HaraldForare/axis-projekt/media/IMG_20230502_111449.jpg

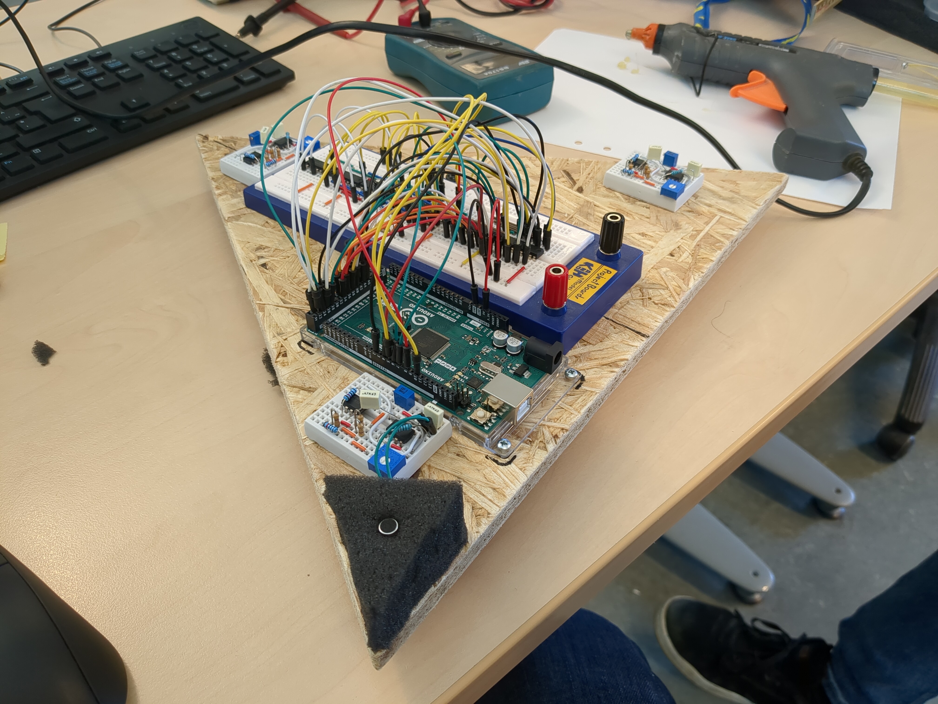
media/IMG_20230502_111449.jpg
