HaraldForare/axis-projekt/media/IMG_20230322_181715.jpg

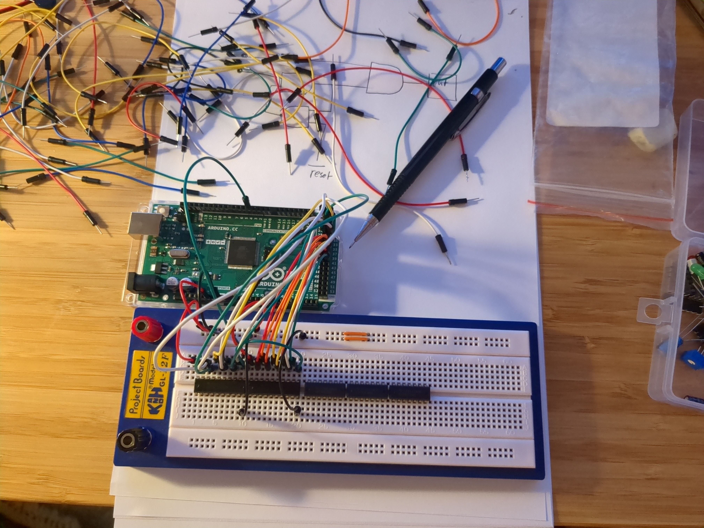
media/IMG_20230322_181715.jpg
