HaraldForare/axis-projekt/datasheets/AND_pinout.png

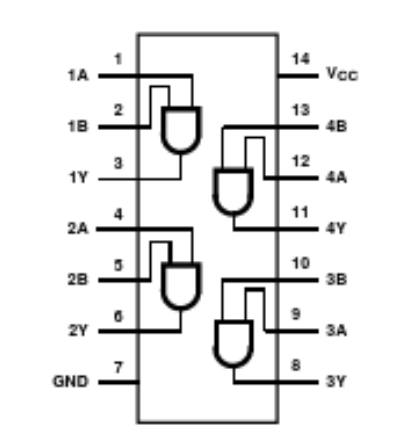
datasheets/AND_pinout.png
