HaraldForare/axis-projekt/datasheets/NAND_CD74HC00E.jpg

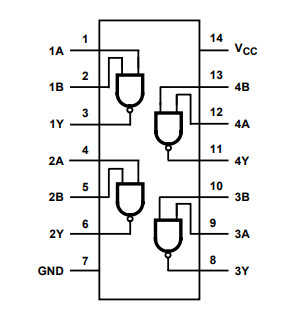
datasheets/NAND_CD74HC00E.jpg
