HaraldForare/axis-projekt/media/330957597_1179710302745747_4111378459915250923_n.png

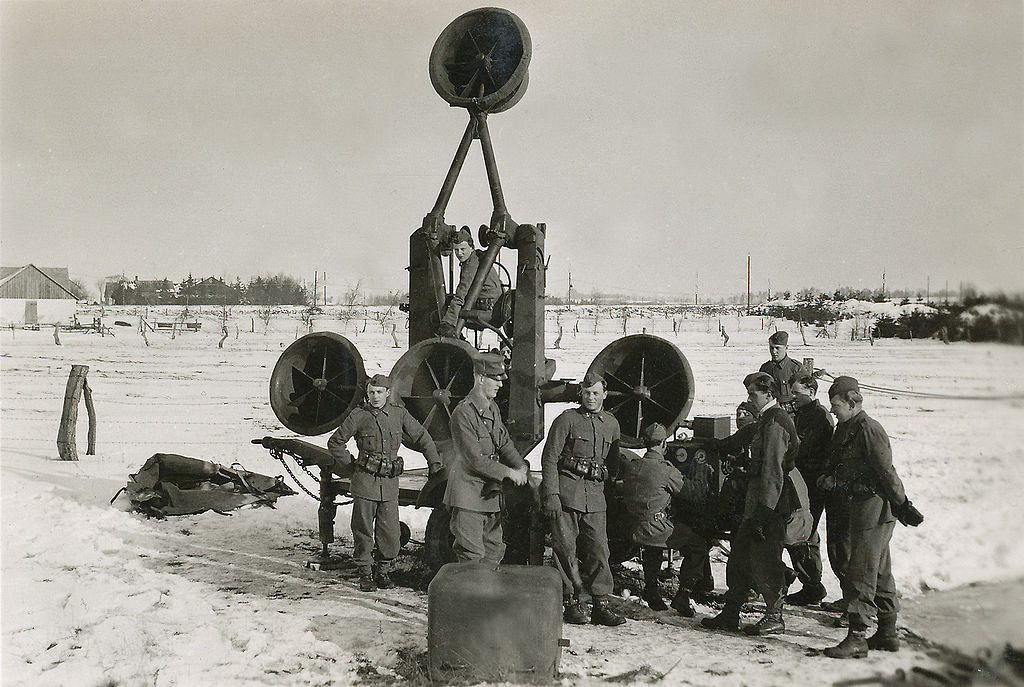
media/330957597_1179710302745747_4111378459915250923_n.png
