HaraldForare/axis-projekt/media/336671804_249828530824881_1593877158184872335_n.png

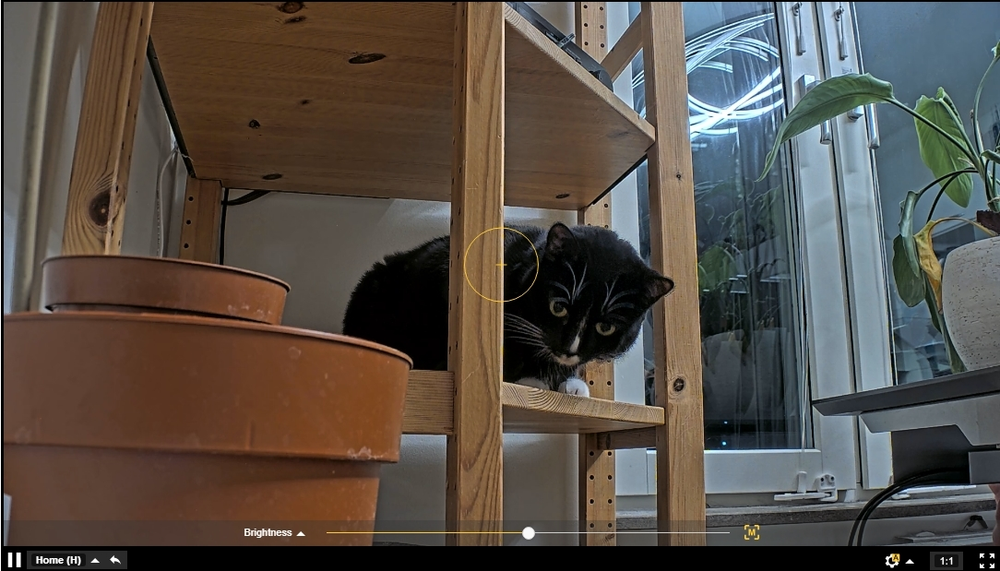
media/336671804_249828530824881_1593877158184872335_n.png
