HaraldForare/axis-projekt/media/a0136a22-0558-4ce8-bf5c-b5d135ed7b40photo.jpeg

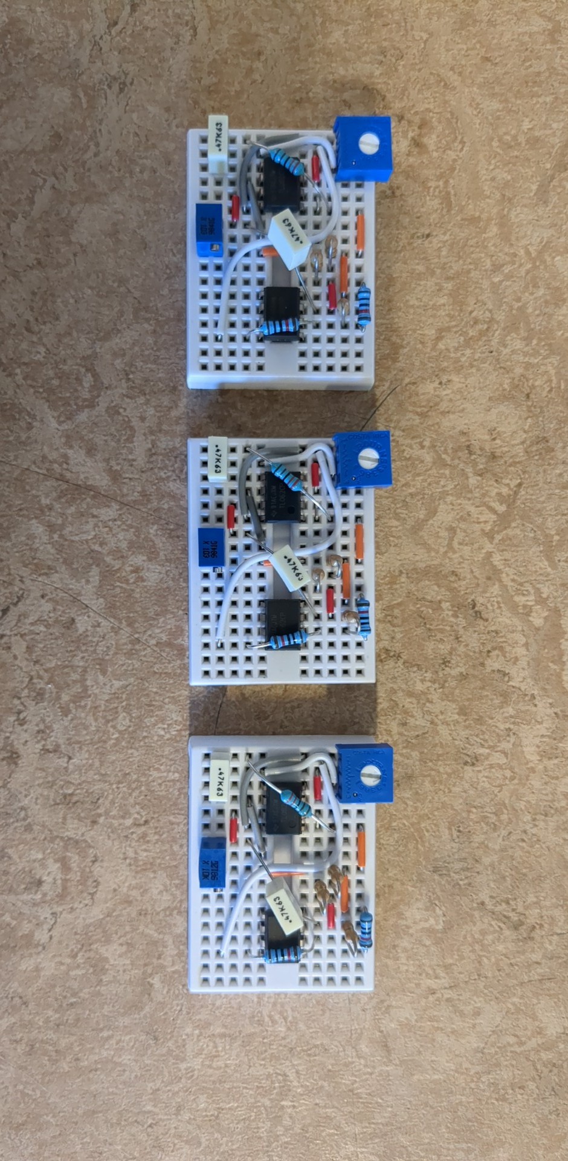
media/a0136a22-0558-4ce8-bf5c-b5d135ed7b40photo.jpeg
