HaraldForare/axis-projekt/media/algo_demo.png

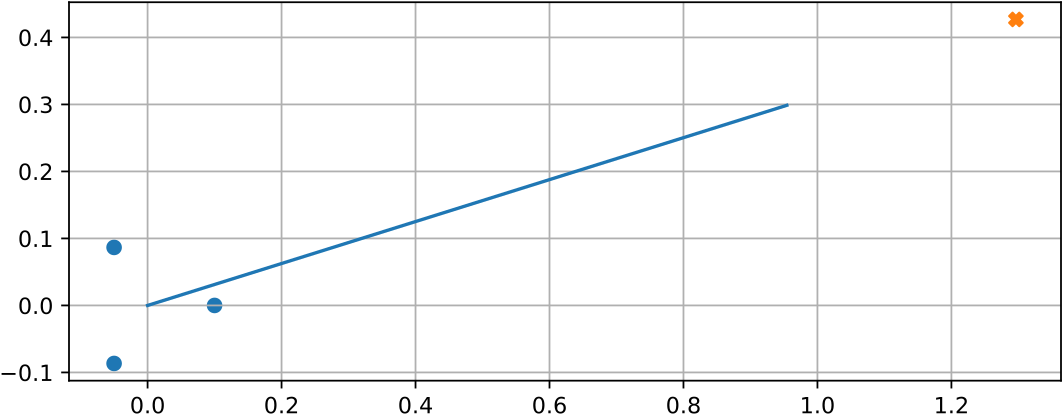
media/algo_demo.png
