HaraldForare/axis-projekt/media/clock_gate_and_counters.jpg

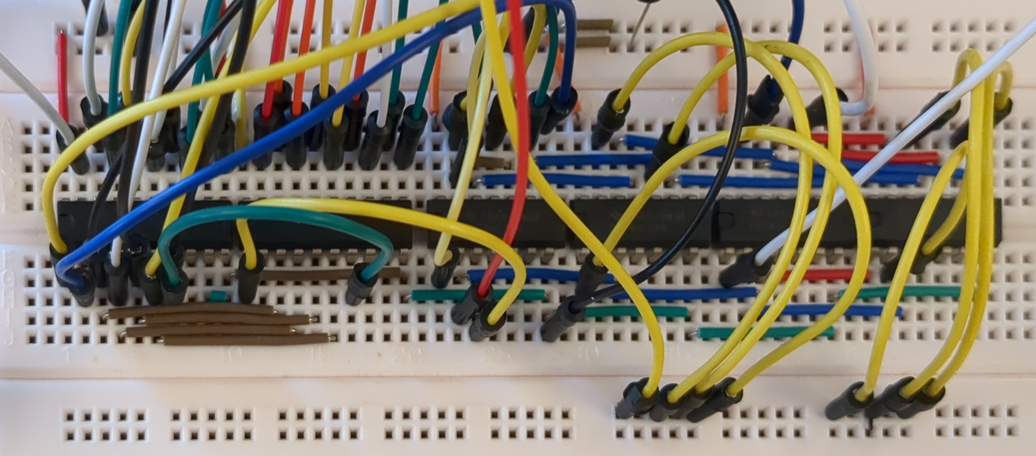
media/clock_gate_and_counters.jpg
