HaraldForare/axis-projekt/media/error_sim.png

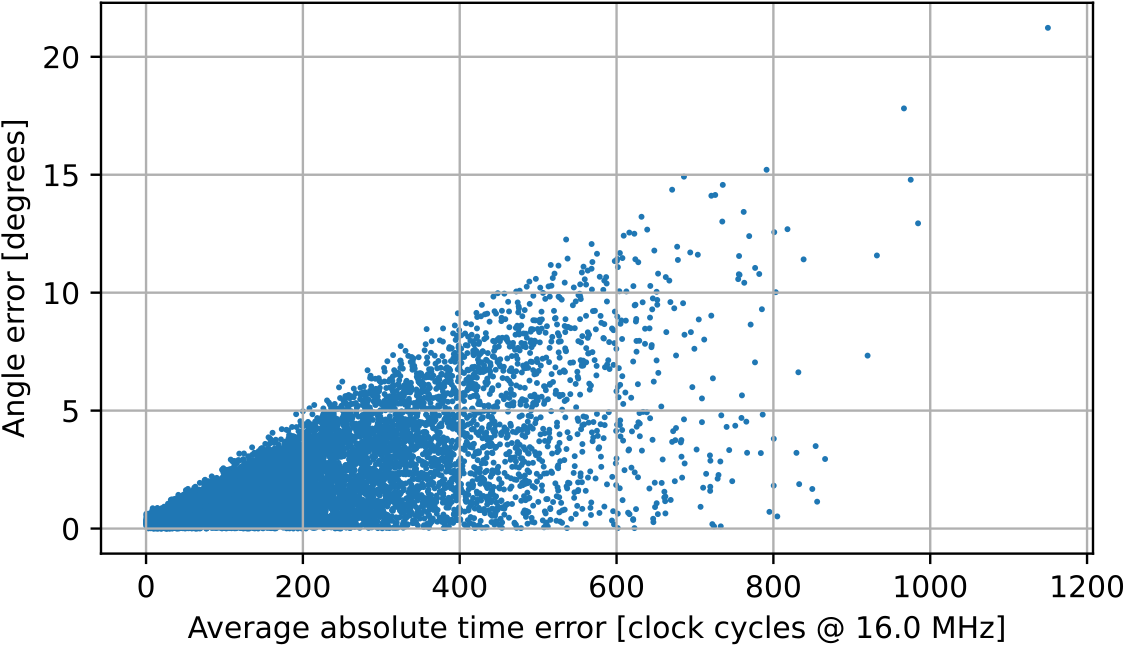
media/error_sim.png
