HaraldForare/axis-projekt/media/hardware_schematic.png

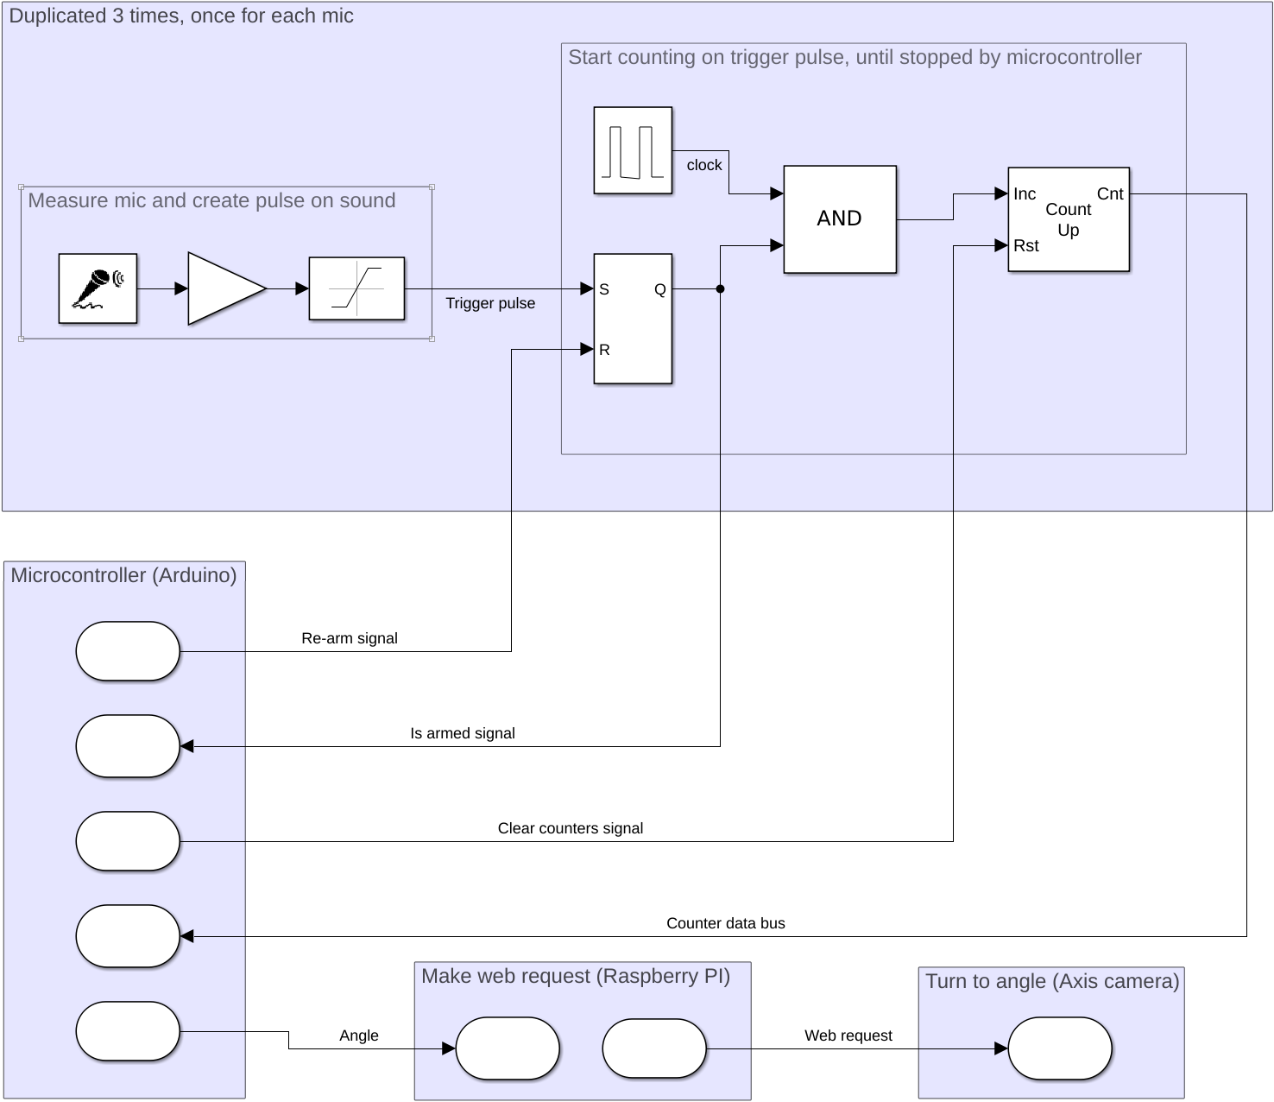
media/hardware_schematic.png
