HaraldForare/axis-projekt/media/IMG_20230328_145824.jpg

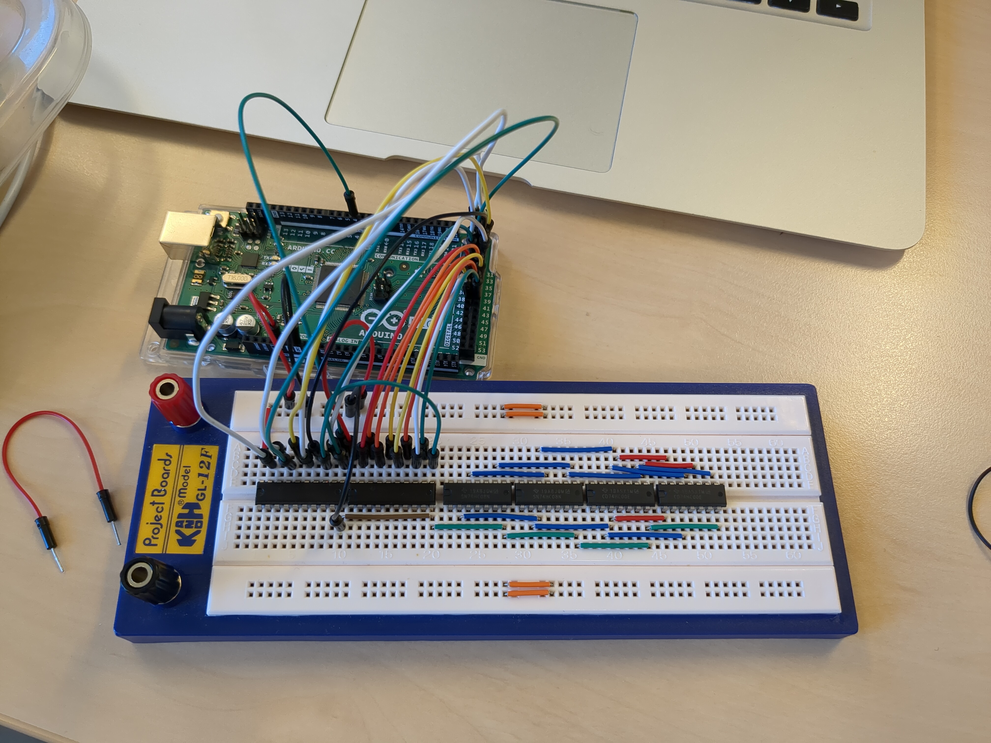
media/IMG_20230328_145824.jpg
