HaraldForare/axis-projekt/media/IMG_20230328_155254.jpg

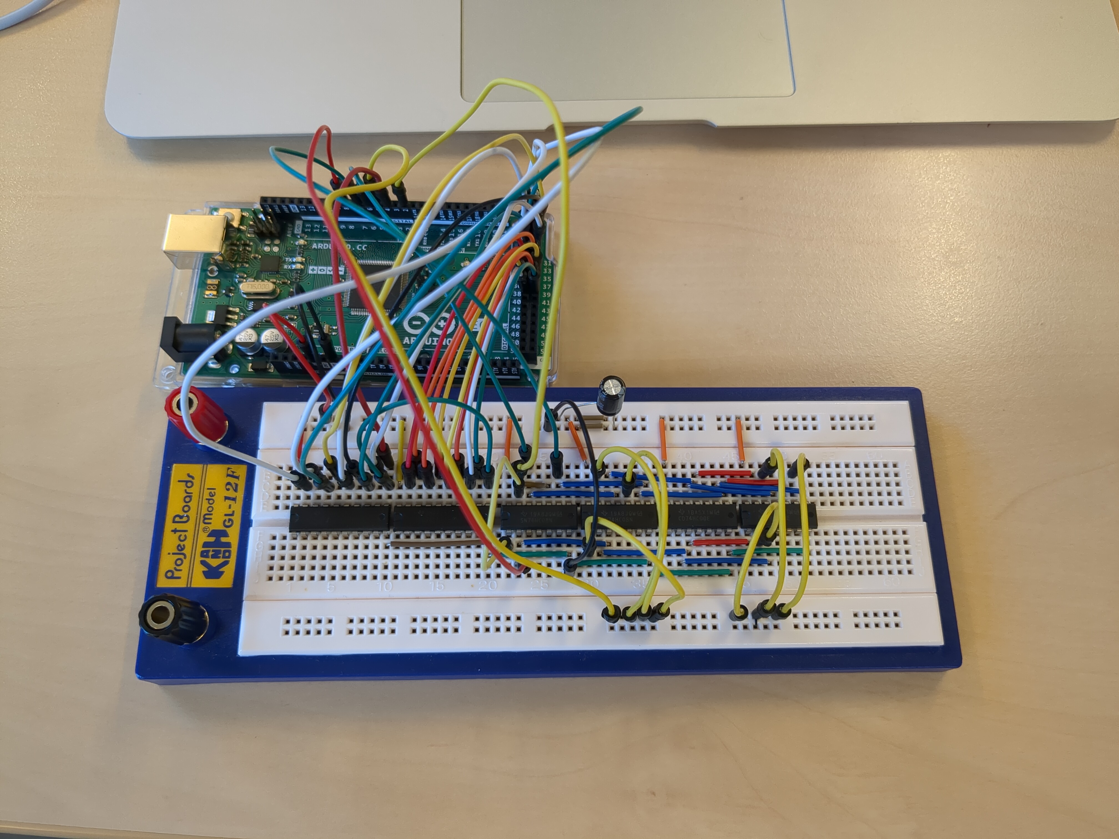
media/IMG_20230328_155254.jpg
