HaraldForare/axis-projekt/media/IMG_20230328_155257.jpg

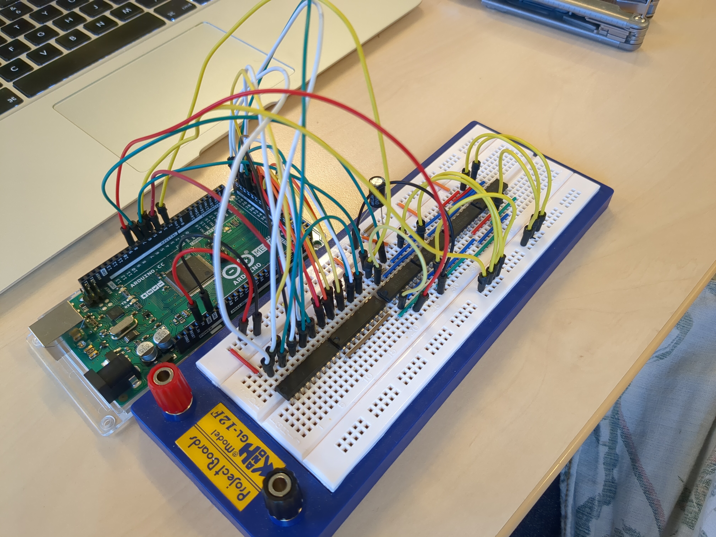
media/IMG_20230328_155257.jpg
