HaraldForare/axis-projekt/media/IMG_20230328_155301.jpg

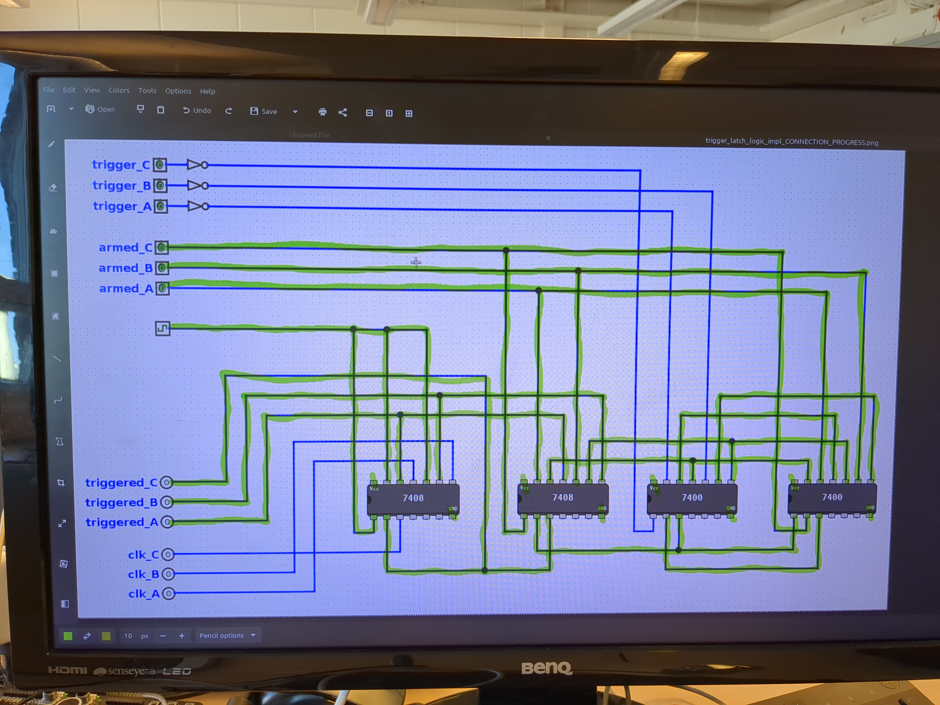
media/IMG_20230328_155301.jpg
