HaraldForare/axis-projekt/media/IMG_20230329_152503.jpg

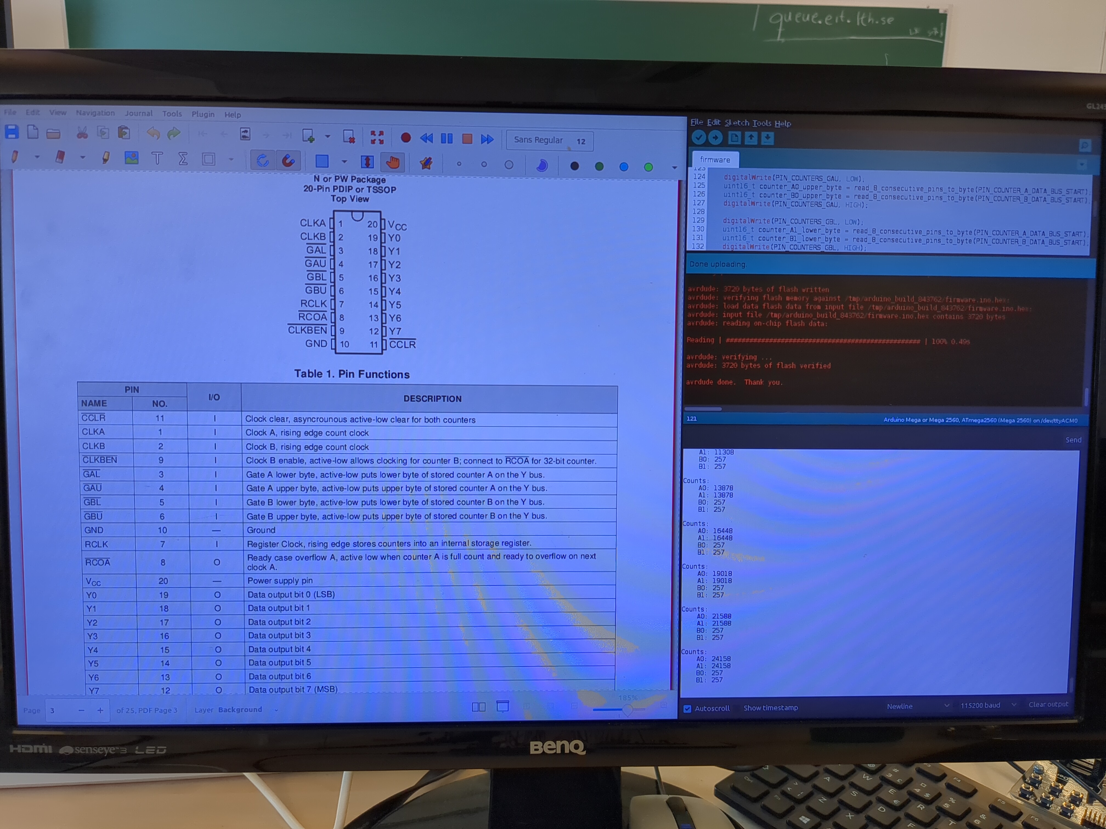
media/IMG_20230329_152503.jpg
