HaraldForare/axis-projekt/media/IMG_20230329_155044.jpg

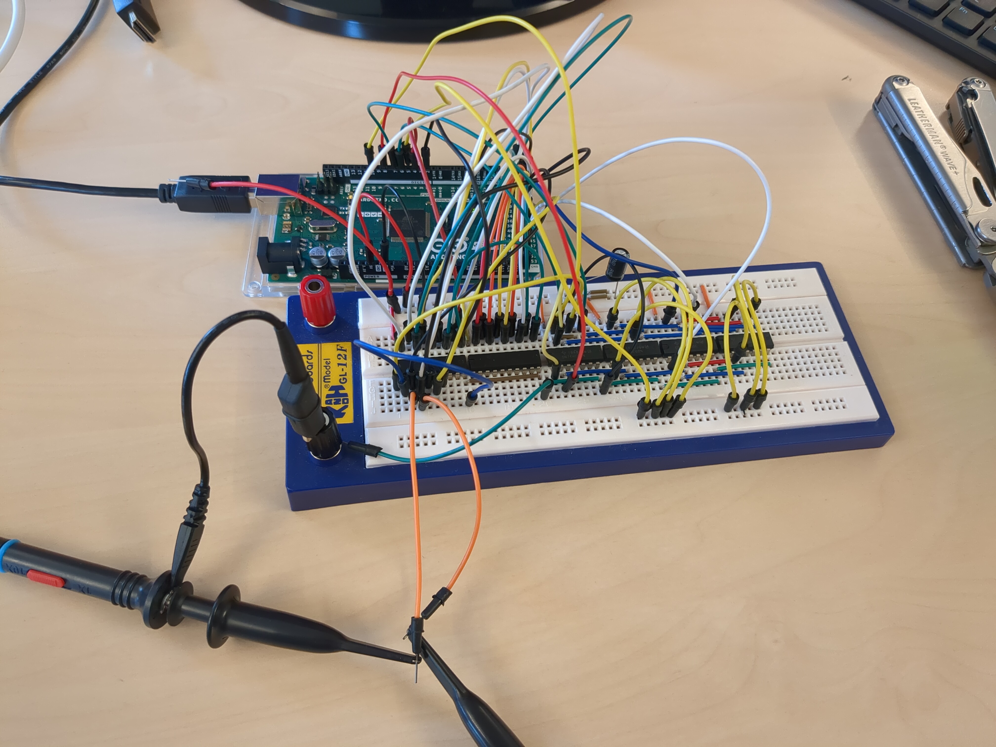
media/IMG_20230329_155044.jpg
