HaraldForare/axis-projekt/media/IMG_20230329_155048.jpg

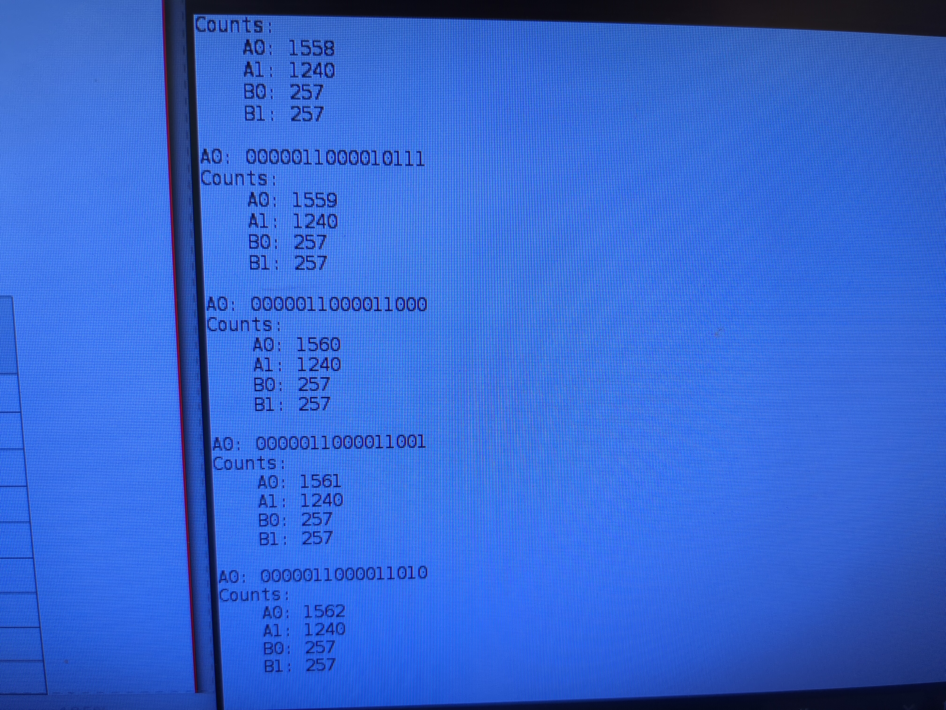
media/IMG_20230329_155048.jpg
