HaraldForare/axis-projekt/media/IMG_20230329_161904.jpg

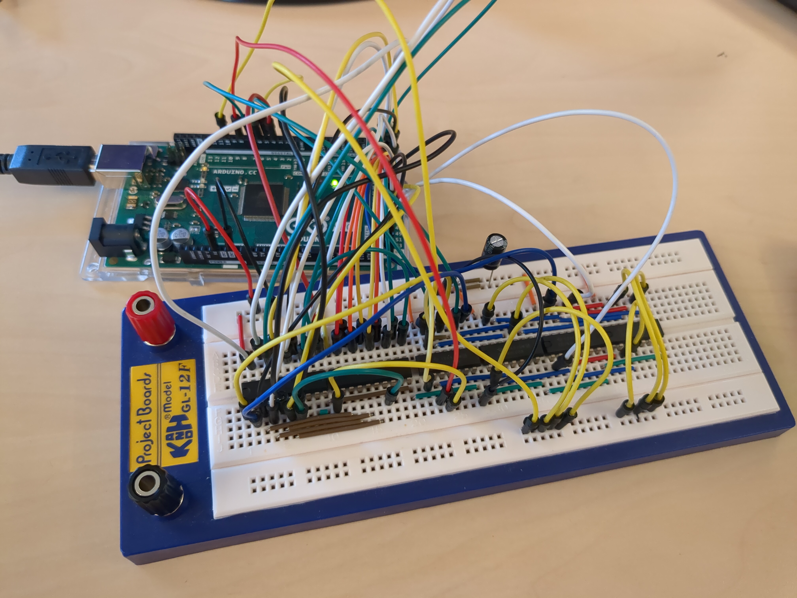
media/IMG_20230329_161904.jpg
