HaraldForare/axis-projekt/media/IMG_20230405_132759.jpg

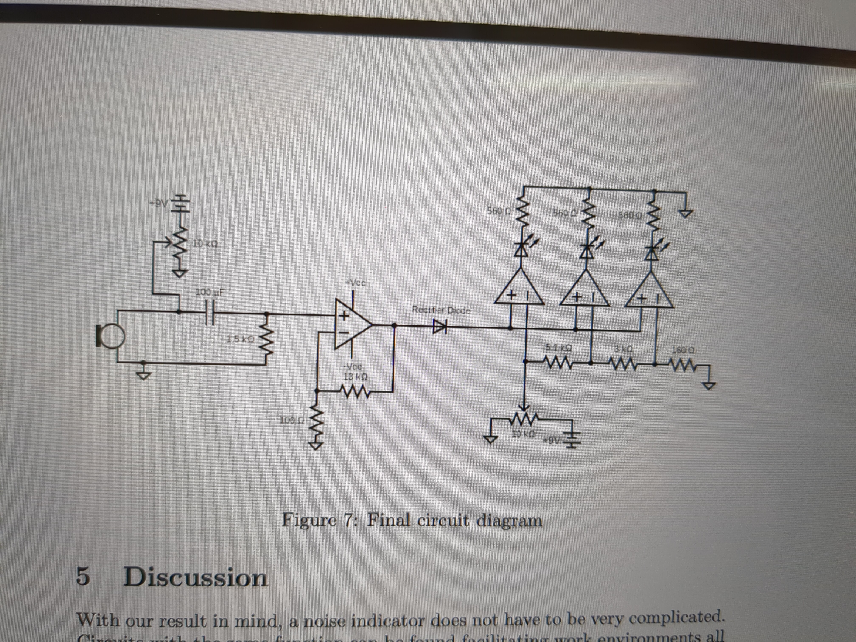
media/IMG_20230405_132759.jpg
