HaraldForare/axis-projekt/media/IMG_20230424_140616.jpg

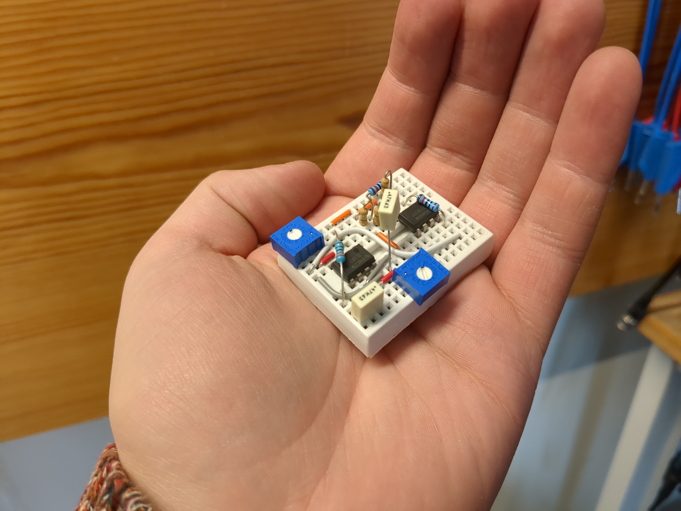
media/IMG_20230424_140616.jpg
