HaraldForare/axis-projekt/media/IMG_20230424_140627.jpg

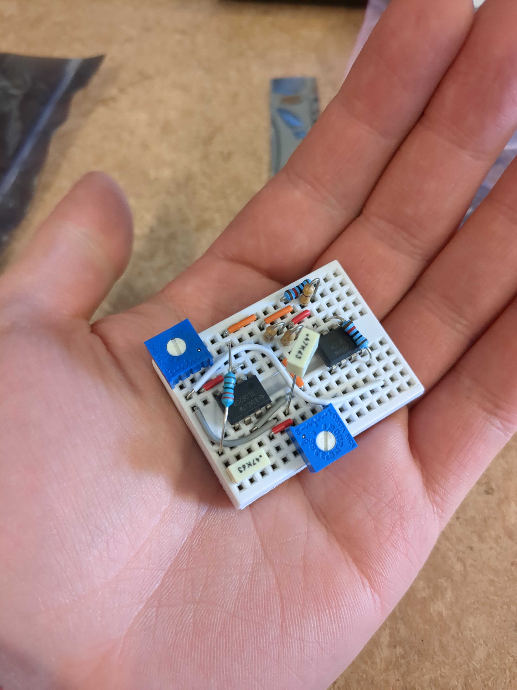
media/IMG_20230424_140627.jpg
