HaraldForare/axis-projekt/media/IMG_20230424_144658.jpg

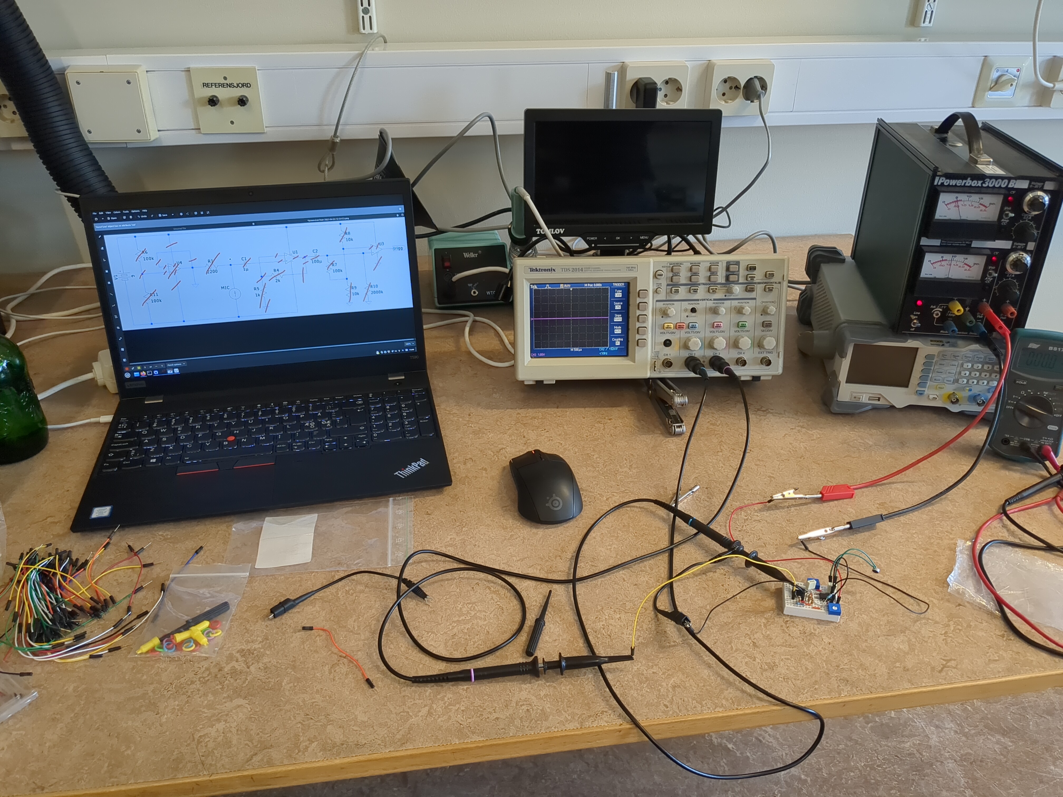
media/IMG_20230424_144658.jpg
