HaraldForare/axis-projekt/media/IMG_20230424_144702.jpg

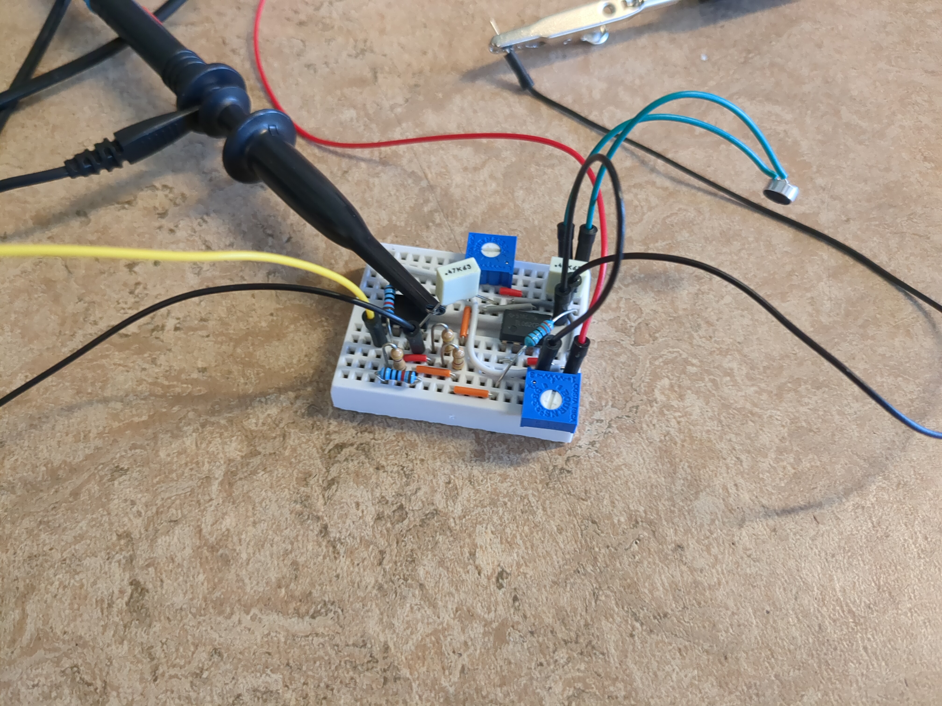
media/IMG_20230424_144702.jpg
