HaraldForare/axis-projekt/media/IMG_20230424_151343.jpg

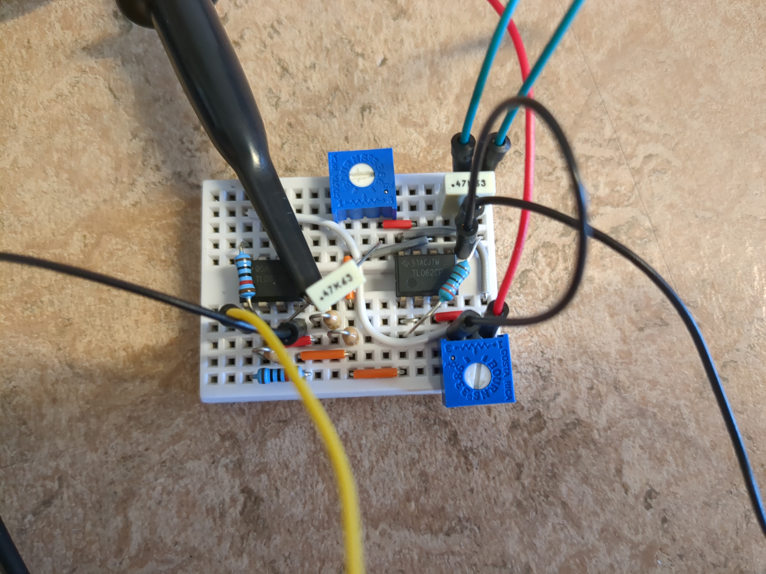
media/IMG_20230424_151343.jpg
