HaraldForare/axis-projekt/media/IMG_20230424_151351.jpg

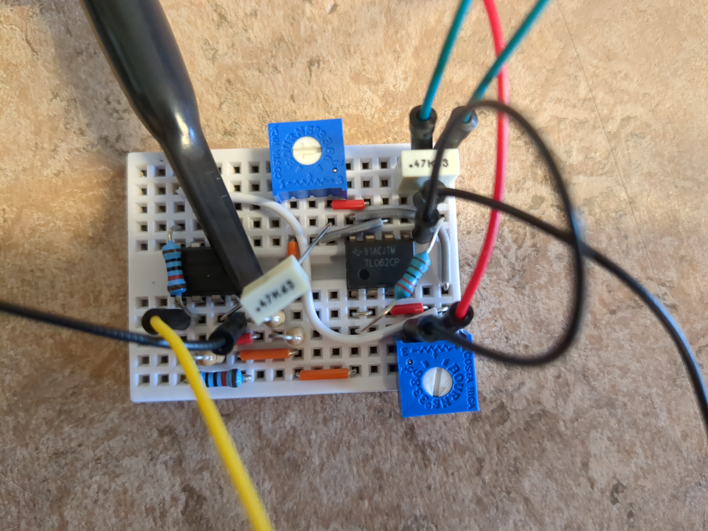
media/IMG_20230424_151351.jpg
