HaraldForare/axis-projekt/media/IMG_20230424_152933.jpg

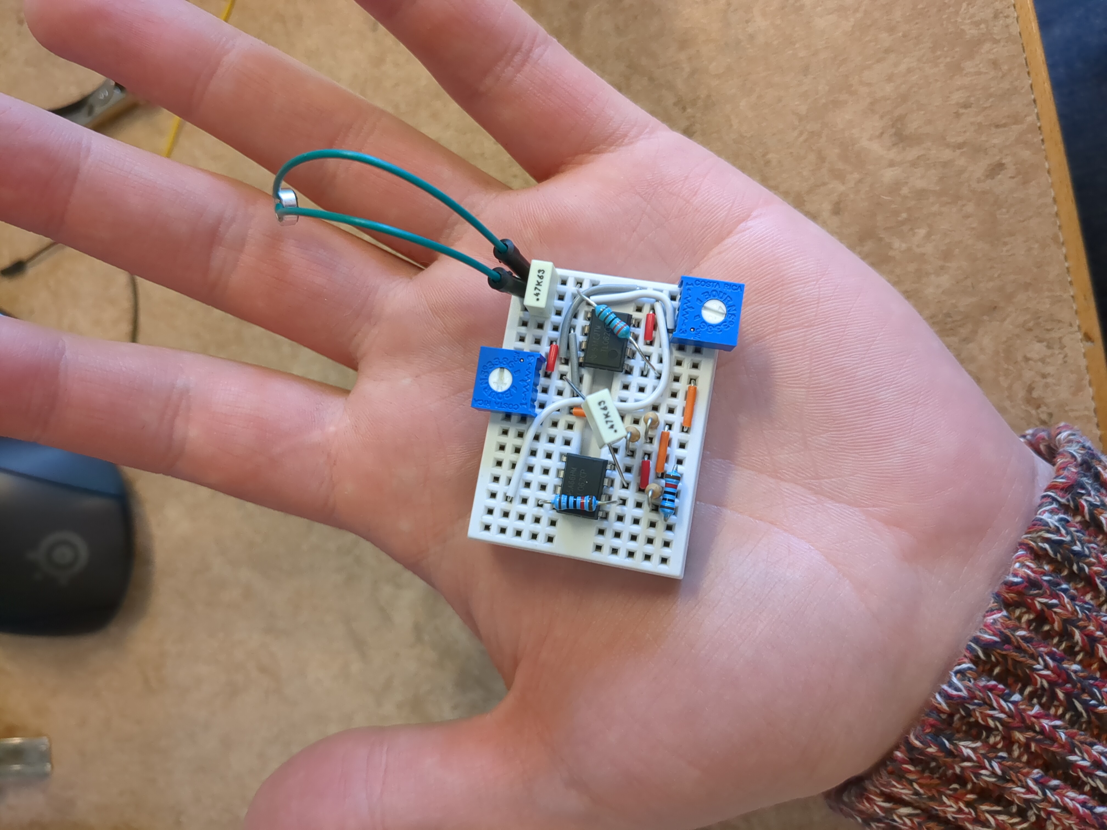
media/IMG_20230424_152933.jpg
