HaraldForare/axis-projekt/media/IMG_20230501_114342.jpg

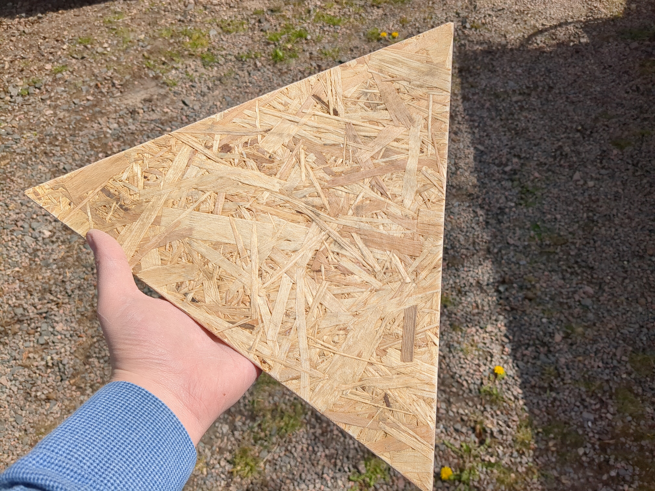
media/IMG_20230501_114342.jpg
