HaraldForare/axis-projekt/media/IMG_20230502_113803.jpg

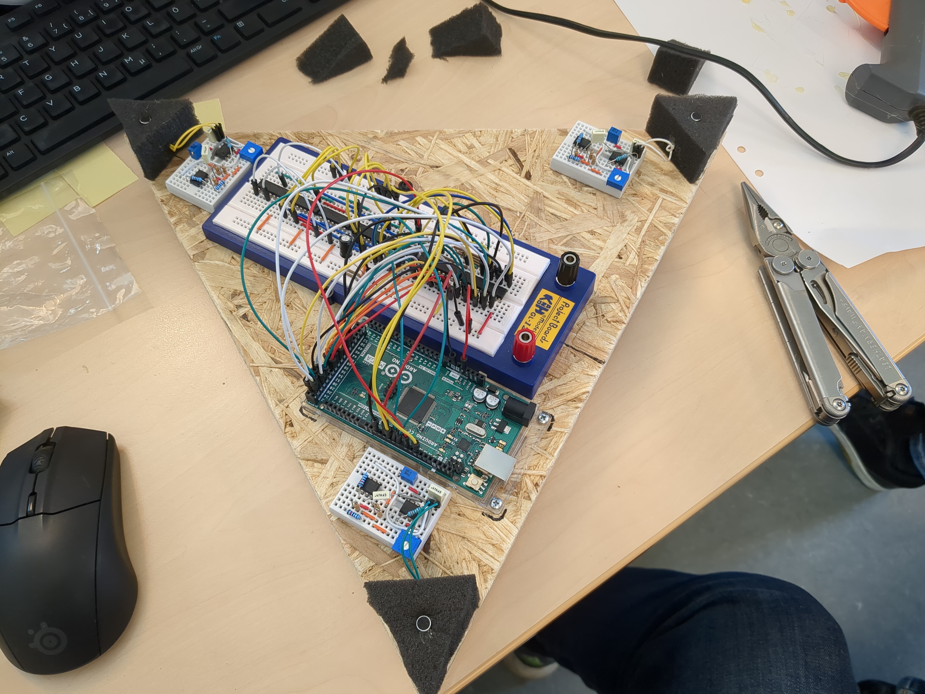
media/IMG_20230502_113803.jpg
