HaraldForare/axis-projekt/media/IMG_20230502_130349.jpg

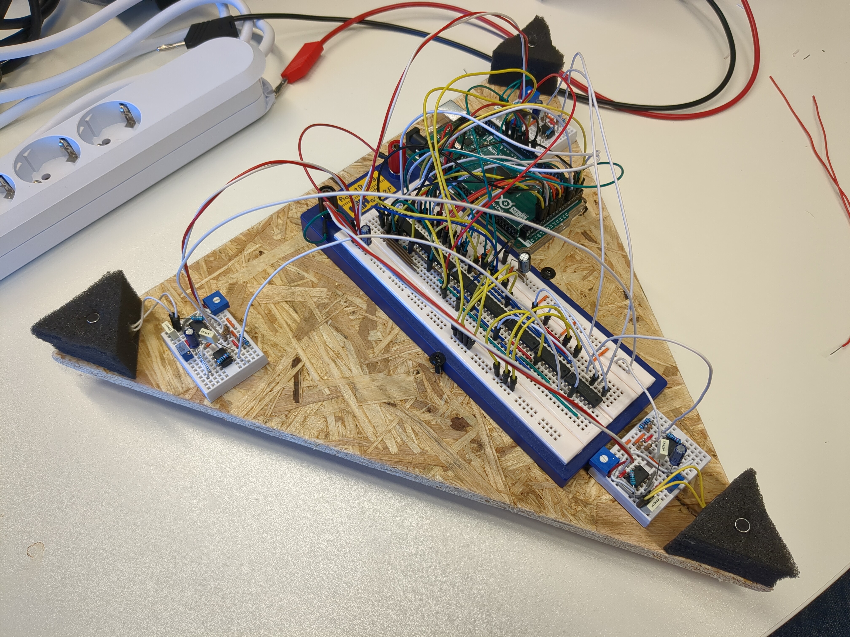
media/IMG_20230502_130349.jpg
