HaraldForare/axis-projekt/media/IMG_20230502_130406.jpg

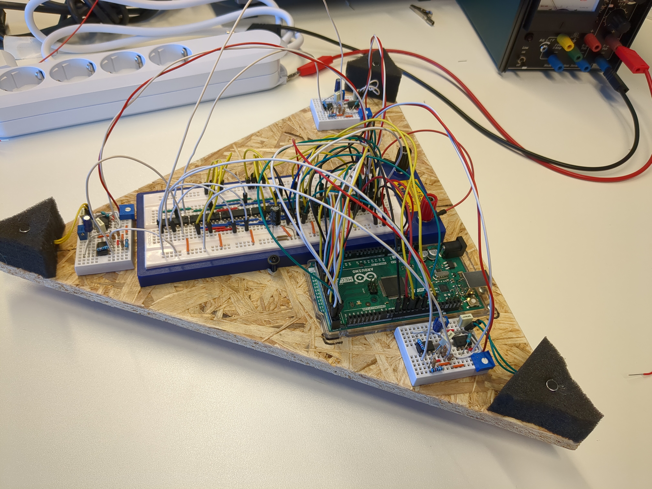
media/IMG_20230502_130406.jpg
