HaraldForare/axis-projekt/media/IMG_20230502_143550.jpg

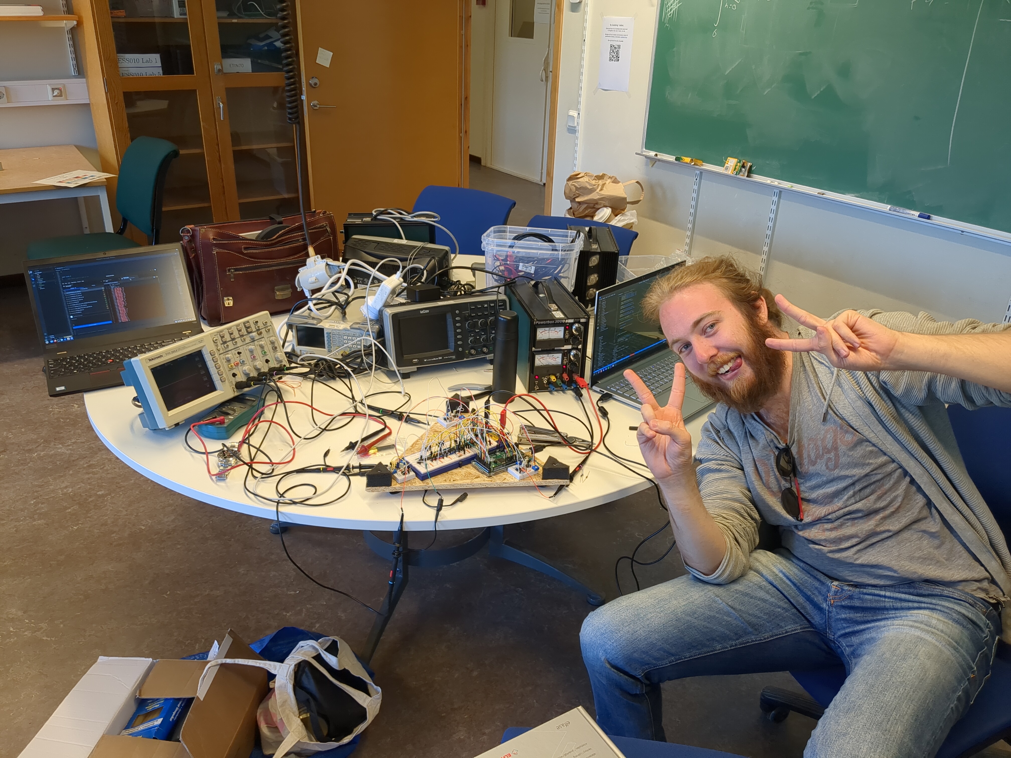
media/IMG_20230502_143550.jpg
