HaraldForare/axis-projekt/media/IMG_20230504_100548.jpg

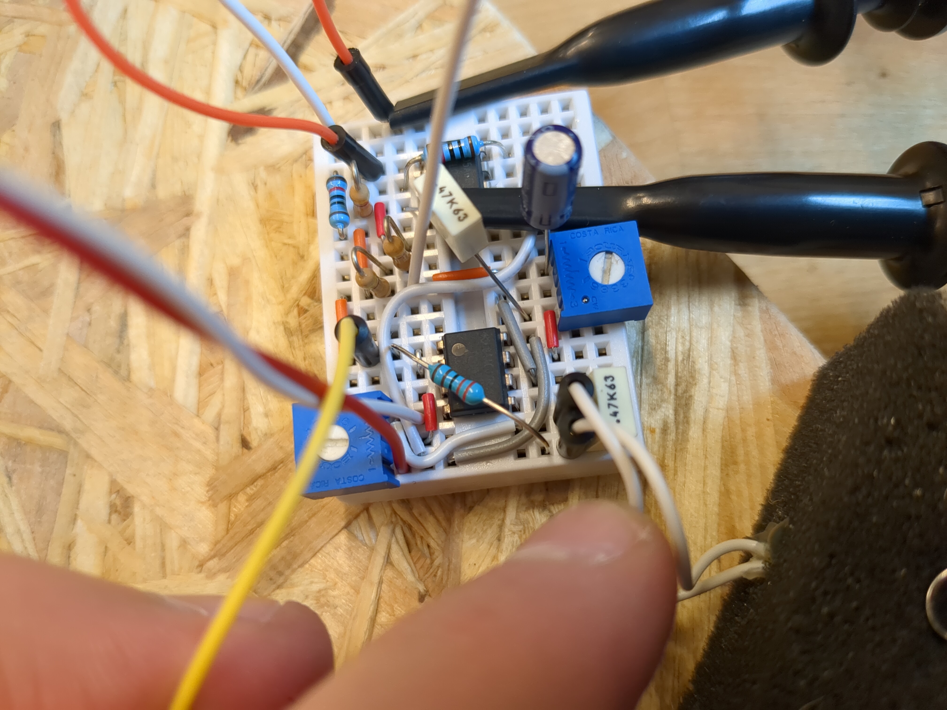
media/IMG_20230504_100548.jpg
