HaraldForare/axis-projekt/media/integrerat_system.jpg

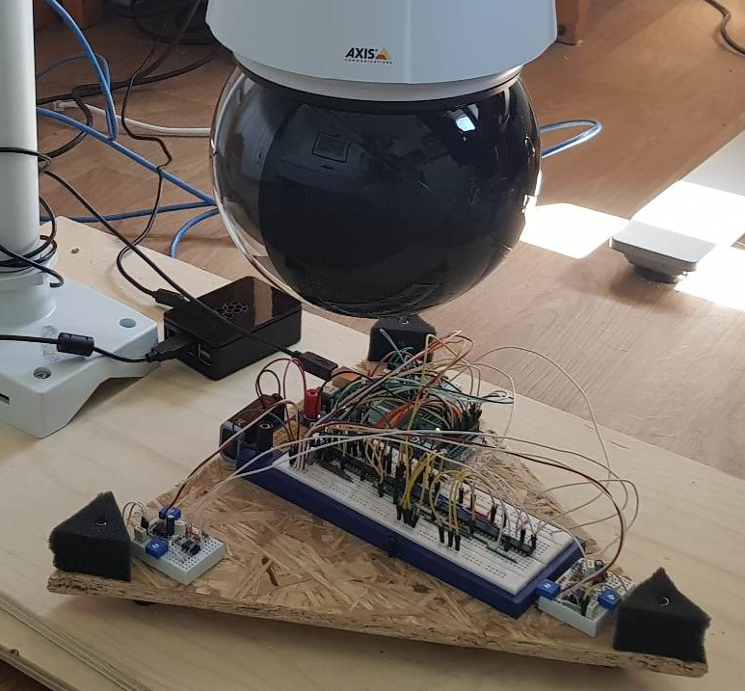
media/integrerat_system.jpg
