HaraldForare/axis-projekt/media/logic_implemented_sim.png

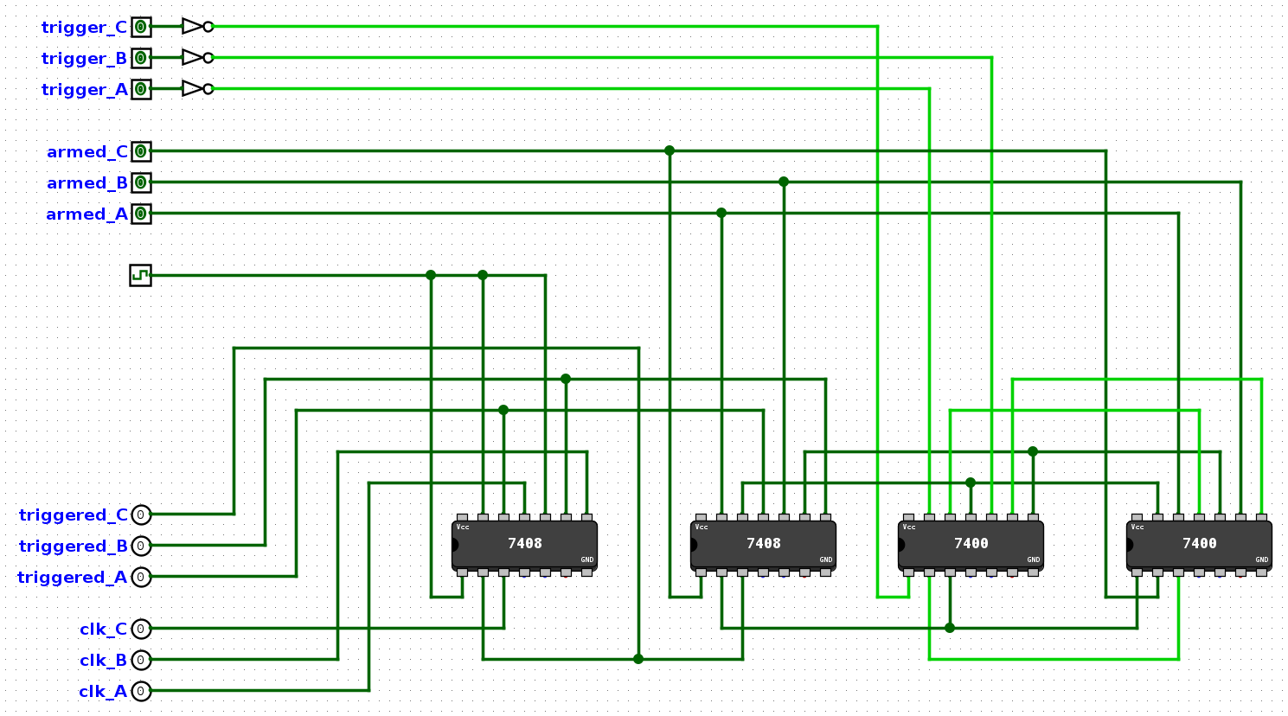
media/logic_implemented_sim.png
