HaraldForare/axis-projekt/media/rubber_feet.jpg

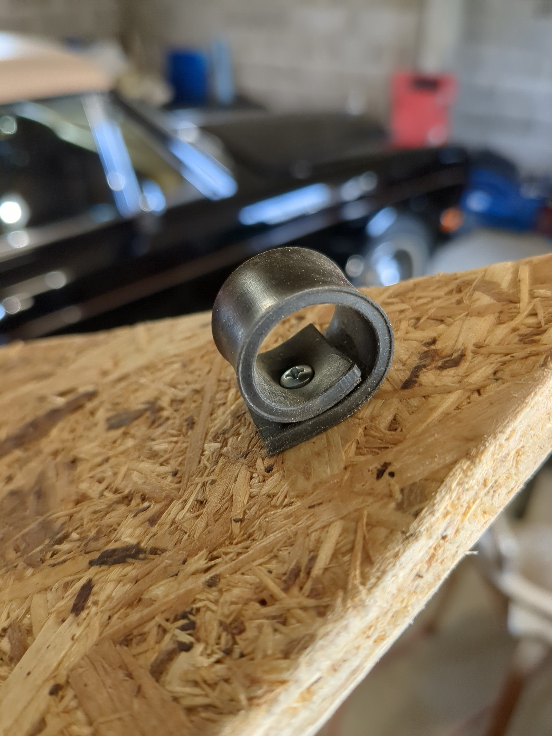
media/rubber_feet.jpg
