HaraldForare/axis-projekt/media/trigger_latch_logic_idea.png

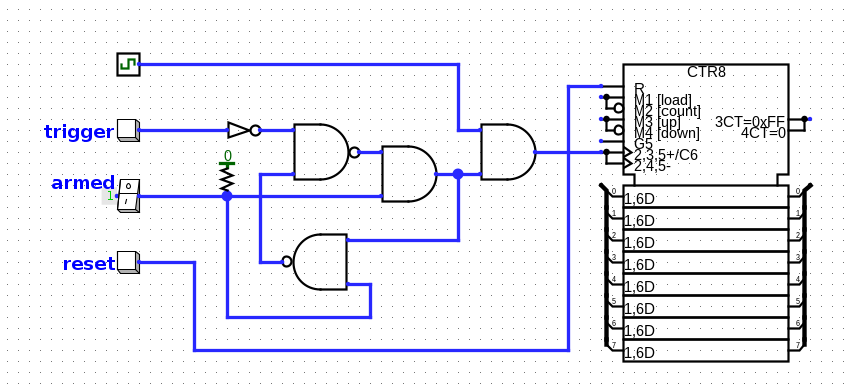
media/trigger_latch_logic_idea.png
