HaraldForare/axis-projekt/media/trigger_latch_logic_impl.png

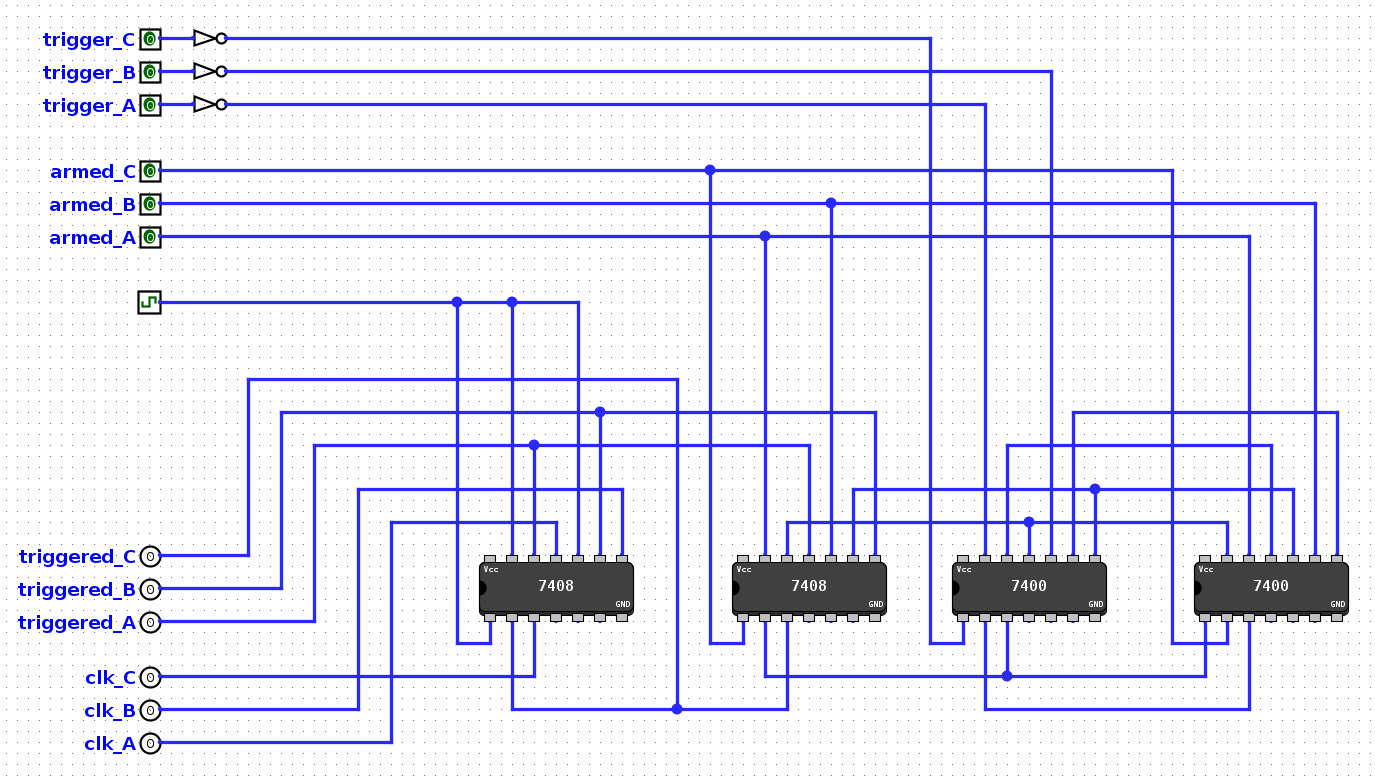
media/trigger_latch_logic_impl.png
