HaraldForare/axis-projekt/media/trigger_latch_logic_impl_CONNECTION_PROGRESS.png

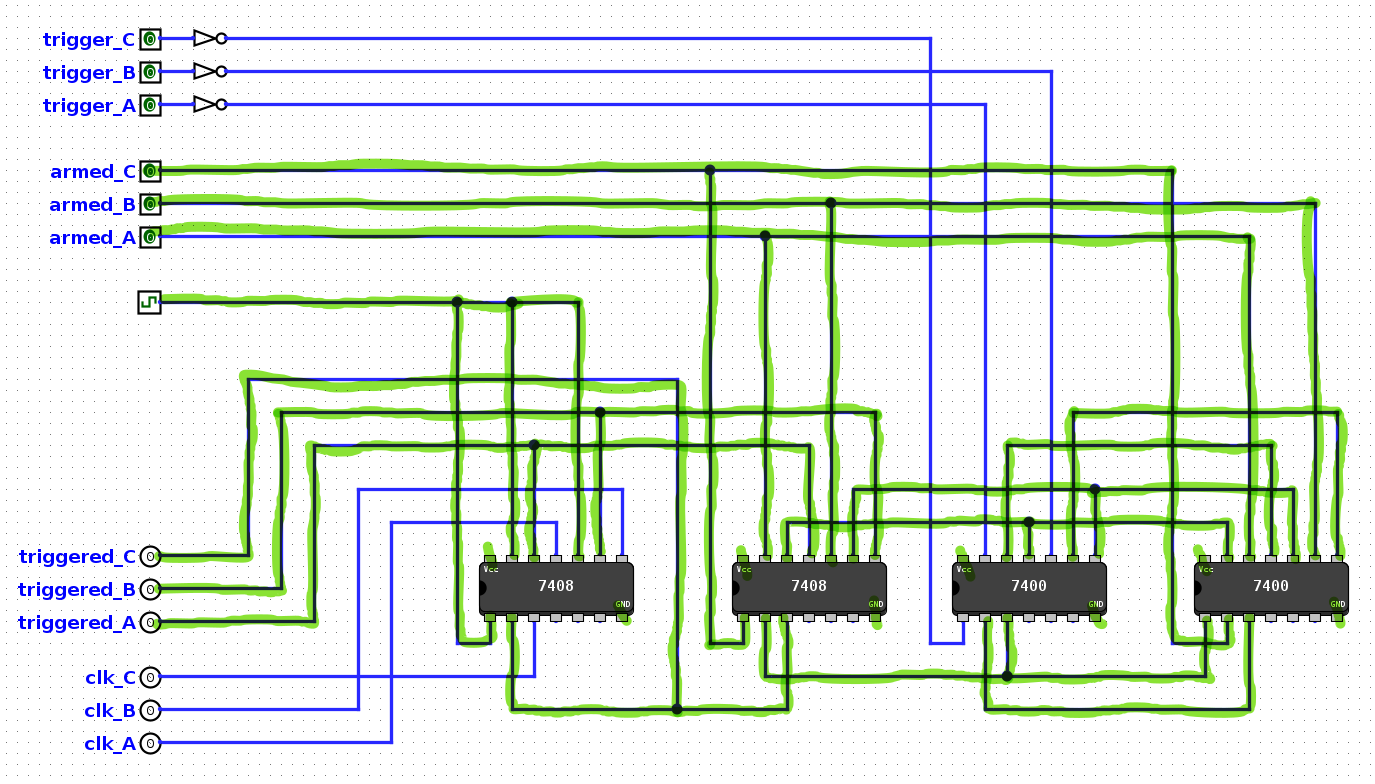
media/trigger_latch_logic_impl_CONNECTION_PROGRESS.png
