HaraldForare/axis-projekt/media/example_debug_output.png

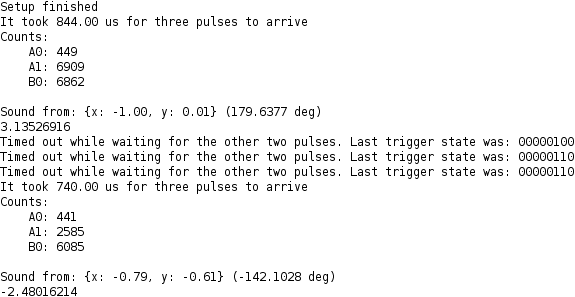
media/example_debug_output.png
