HaraldForare/axis-projekt/analog/condenser_mic_amp.asc

C1: cap; 1µ
C2: cap; 100µ
MIC: current; SINE(0 0.0001 2000 0 0 0 0.5)
R1: res; 2200
R4: res; 2k
R5: res; 1k
R6: res; 100k
R7: res; 100k
R8: res; 10k
R9: res; 10k
R10: res; 2000k
R11: res; 100k
U1: UniversalOpAmp2
U3: UniversalOpAmp2
U4: UniversalOpAmp2
V1: battery; 9
Named nets: 0, trigg
.tran 0.01
