HaraldForare/axis-projekt/(list of files, drawings)

Other design files:
simulation/counter_logic.circ
