HaraldForare/axis-projekt/(commit log)

2023-03-27 Bug fix
    Clock can no longer get through by peaks while the microcontroller is resetting the latch. This fixes a bug where more peaks can increment the counter while we are trying to read it
    [counter_logic.circ]
2023-03-28 Simulated implementation single stage
    Successfully simulated one of the three latch circuits feeding the timer using the same components as in the real world.
    [counter_logic.circ]
2023-03-28 Second circuit wired
    [counter_logic.circ]
2023-03-28 third circuit implemented
    [counter_logic.circ]
2023-03-28 Arduino datasheets
2023-03-29 counting but in a broken way
    [firmware.ino]
2023-04-05 counter reading now happens in a class
    this keeps counts for the three timers together
2023-04-05 function to read timer activations to bits
2023-04-24 input stage now only uses one battery
2023-04-24 Rpi can read from Serial.print via USB. TODO HTTP rq to camera
2023-04-25 Added logging + fixed clippy warnings
    [main.rs]
2023-04-25 self-generated pulses with correct angle calculation demo
    [firmware.ino]
2023-04-25 timer overflow bug fixed
    [firmware.ino]
2023-04-26 debug printing
2023-05-04 pi is already defined in arduino libraries
2023-05-04 added missing newline in debug printout
    [firmware.ino]
2023-05-04 debug printout of degrees also
2023-05-04 Should fix merge conflict?
    [firmware.ino]
2023-05-17 finishing touches
    [counter_logic.circ]
