HaraldForare/axis-projekt/media/IMG_20230329_161909.jpg

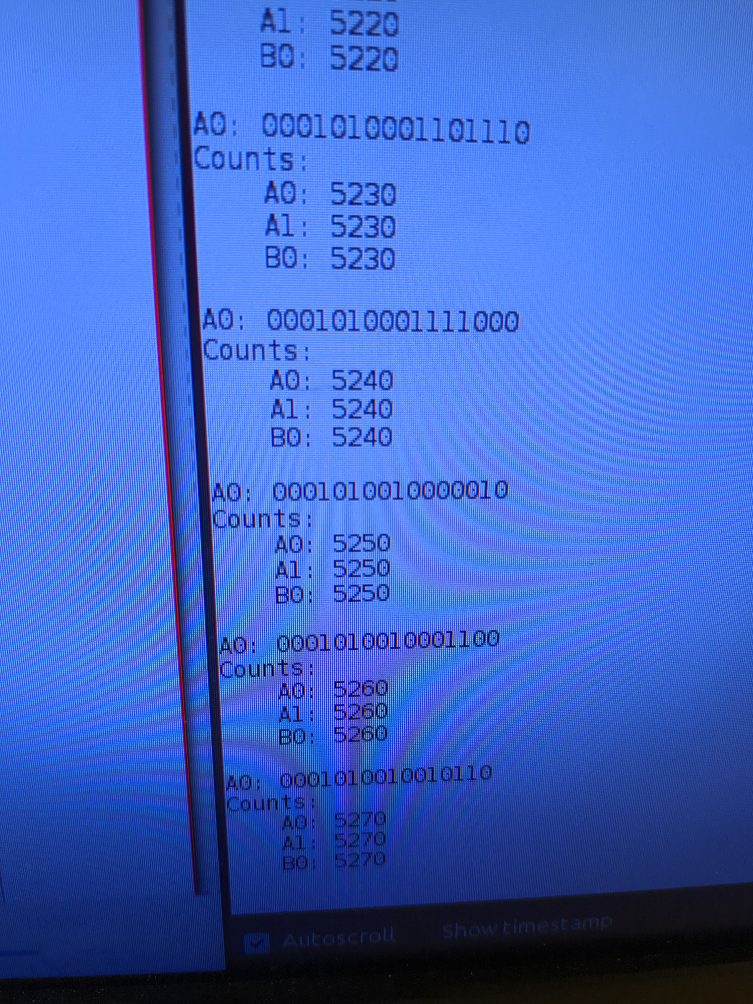
media/IMG_20230329_161909.jpg
